jhpark16/Li-ion-Battery-Charger-Discharger/Simulation/Li-ion_Charger_Circuit_Simulation.asc

Li-ion_Battery: voltage; 8.4; Rser=0.1
M1: nmos; IRFZ44N
Q1: npn; 2N3904
R1: res; 10k
R2: res; 330k
R3: res; 150k
R4: res; 0.1
R5: res; 0.5
R6: res; 470k
R7: res; 150k
R8: res; 470k
R9: res; 556.42
R10: res; 100k
U1: opamp2; LM358
U2: opamp2; LM358
U3: opamp2; LM358
V1: voltage; 9; Rser=0.01
V2: voltage; PULSE(0 2 30 1ms 1ms 30 60 1)
Named nets: 0
.include LM358.sub
Vout1
Vout2
.tran 60
