jhpark16/Li-ion-Battery-Charger-Discharger/Src/main.c

/**
  ******************************************************************************
  * @file           : main.c
  * @brief          : Main program body
  ******************************************************************************
  * This notice applies to any and all portions of this file
  * that are not between comment pairs USER CODE BEGIN and
  * USER CODE END. Other portions of this file, whether 
  * inserted by the user or by software development tools
  * are owned by their respective copyright owners.
  *
  * Copyright (c) 2018 STMicroelectronics International N.V. 
  * All rights reserved.
  *
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
  ******************************************************************************
  */
/* Includes ------------------------------------------------------------------*/
#include "main.h"
#include "stm32f1xx_hal.h"
#include "cmsis_os.h"
#include "usb_device.h"

/* USER CODE BEGIN Includes */
#include "usbd_cdc_if.h"
#include "pcf8574.h"
#include "hd44780.h"

/* USER CODE END Includes */

ADC_HandleTypeDef hadc1;
ADC_HandleTypeDef hadc2;

I2C_HandleTypeDef hi2c1;

RTC_HandleTypeDef hrtc;

TIM_HandleTypeDef htim1;

osThreadId defaultTaskHandle;
osThreadId Task2Handle;
osThreadId Task3Handle;

/* USER CODE BEGIN PV */
#define USB_TX_BUFFER_SIZE 64
#define USB_RX_BUFFER_SIZE 64
 
uint8_t usbCdcTxBuffer[USB_TX_BUFFER_SIZE];
uint8_t usbCdcTxBuffer2[USB_TX_BUFFER_SIZE];
uint8_t usbCdcRxBuffer[USB_RX_BUFFER_SIZE];
int received_data_size = 0;
int receive_total =0; 		

uint8_t toggle=0;
//PCF8574_HandleTypeDef	pcf;
LCD_PCF8574_HandleTypeDef	lcd;

/* Buffers used for displaying Time and Date */
uint32_t startCounter;
uint8_t aShowTime[50] = {0};
uint8_t aShowDate[50] = {0};
int ema_N=60;
double ema_k, ema_Vvalue=0.0, ema_Avalue=0.0;

/* USER CODE END PV */

void SystemClock_Config(void);
static void MX_GPIO_Init(void);
static void MX_TIM1_Init(void);
static void MX_I2C1_Init(void);
static void MX_RTC_Init(void);
static void MX_ADC1_Init(void);
static void MX_ADC2_Init(void);
void StartDefaultTask(void const * argument);
void vTask2(void const * argument);
void vTask3(void const * argument);

/* USER CODE BEGIN PFP */
static void RTC_CalendarConfig(void);
static void RTC_CalendarShow(uint8_t *showtime, uint8_t *showdate);
static uint32_t RTC_ReadTimeCounter(RTC_HandleTypeDef* hrtc);

#define ITM_Port8(n)    (*((volatile unsigned char *)(0xE0000000+4*n)))
#define ITM_Port16(n)   (*((volatile unsigned short*)(0xE0000000+4*n)))
#define ITM_Port32(n)   (*((volatile unsigned long *)(0xE0000000+4*n)))

#define DEMCR           (*((volatile unsigned long *)(0xE000EDFC)))
#define TRCENA          0x01000000

struct __FILE { int handle; /* Add whatever you need here */ };
FILE __stdout;
FILE __stdin;

int fputc(int ch, FILE *f) {
//  if (DEMCR & TRCENA) {
//    while (ITM_Port32(0) == 0);
//    ITM_Port8(0) = ch;
//  }
  ITM_SendChar(ch);
  return(ch);
}


/* USER CODE END PFP */

/**
  * @brief  The application entry point.
  *
  * @retval None
  */
int main(void)
{
  /* MCU Configuration----------------------------------------------------------*/

  /* Reset of all peripherals, Initializes the Flash interface and the Systick. */
  HAL_Init();

  /* Configure the system clock */
  SystemClock_Config();

  /* Initialize all configured peripherals */
  MX_GPIO_Init();
  MX_TIM1_Init();
  MX_I2C1_Init();
  MX_RTC_Init();
  MX_ADC1_Init();
  MX_ADC2_Init();
  /* USER CODE BEGIN 2 */

  // Start the timer 1
  HAL_TIM_Base_Start_IT(&htim1);

  // LCDI2C_init
  // The I2C address is 0x20 + A2,A1,A0
  // A2, A1, A0 of PCF8574 are high (open)
  lcd.pcf8574.PCF_I2C_ADDRESS = 0x27;
  lcd.pcf8574.PCF_I2C_TIMEOUT = 1000;
  lcd.pcf8574.i2c.Instance = I2C1;
  lcd.pcf8574.i2c.Init.ClockSpeed = 400000;
  lcd.NUMBER_OF_LINES = NUMBER_OF_LINES_2; // Just use 2 lines instead of 4
  lcd.type = TYPE0;

  if(LCD_Init(&lcd)!=LCD_OK){
	  // error occured
    Error_Handler();
  }
  // Setup the initial value of real time calendar
  RTC_CalendarConfig();
  // update the startCounter value
  startCounter = RTC_ReadTimeCounter(&hrtc);

	// Calibrate ADC1
  if (HAL_ADCEx_Calibration_Start(&hadc1) != HAL_OK)
  {
    // Calibration Error 
    Error_Handler();
  }
  // Calibrate ADC2
  if (HAL_ADCEx_Calibration_Start(&hadc2) != HAL_OK)
  {
    // Calibration Error
    Error_Handler();
  }
	
  /* USER CODE END 2 */

  /* USER CODE BEGIN RTOS_MUTEX */
  /* add mutexes, ... */
  /* USER CODE END RTOS_MUTEX */

  /* USER CODE BEGIN RTOS_SEMAPHORES */
  /* add semaphores, ... */
  /* USER CODE END RTOS_SEMAPHORES */

  /* USER CODE BEGIN RTOS_TIMERS */
  /* start timers, add new ones, ... */
  /* USER CODE END RTOS_TIMERS */

  /* Create the thread(s) */
  /* definition and creation of defaultTask */
  osThreadDef(defaultTask, StartDefaultTask, osPriorityNormal, 0, 192);
  defaultTaskHandle = osThreadCreate(osThread(defaultTask), NULL);

  /* definition and creation of Task2 */
  osThreadDef(Task2, vTask2, osPriorityLow, 0, 192);
  Task2Handle = osThreadCreate(osThread(Task2), NULL);

  /* definition and creation of Task3 */
  osThreadDef(Task3, vTask3, osPriorityIdle, 0, 128);
  Task3Handle = osThreadCreate(osThread(Task3), NULL);

  /* USER CODE BEGIN RTOS_THREADS */
  /* add threads, ... */
  /* USER CODE END RTOS_THREADS */

  /* USER CODE BEGIN RTOS_QUEUES */
  /* add queues, ... */
  /* USER CODE END RTOS_QUEUES */
 

  /* Start scheduler */
  osKernelStart();
  
  /* We should never get here as control is now taken by the scheduler */

  /* Infinite loop */
  /* USER CODE BEGIN WHILE */
  while (1)
  {
  /* USER CODE END WHILE */

  /* USER CODE BEGIN 3 */

  }
  /* USER CODE END 3 */

}

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
/* USER CODE BEGIN 4 */
/**
  * @brief  Configure the current time and date.
  * @param  None
  * @retval None
  */
static void RTC_CalendarConfig(void)
{
  RTC_DateTypeDef sdatestructure;
  RTC_TimeTypeDef stimestructure;

  /*##-1- Configure the Date #################################################*/
  /* Set Date: Friday June 1st 2018 */
  sdatestructure.Year = 0x18;
  sdatestructure.Month = RTC_MONTH_JUNE;
  sdatestructure.Date = 0x1;
  sdatestructure.WeekDay = RTC_WEEKDAY_FRIDAY;
  
  if(HAL_RTC_SetDate(&hrtc,&sdatestructure,RTC_FORMAT_BCD) != HAL_OK)
  {
    /* Initialization Error */
    Error_Handler();
  }

  /*##-2- Configure the Time #################################################*/
  /* Set Time: 02:00:00 */
	if (HAL_RTCEx_BKUPRead(&hrtc, RTC_BKP_DR1) != 0x32F2)
	{
		stimestructure.Hours = 0x02;
		stimestructure.Minutes = 0x00;
		stimestructure.Seconds = 0x00;
		
		if (HAL_RTC_SetTime(&hrtc, &stimestructure, RTC_FORMAT_BCD) != HAL_OK)
		{
			/* Initialization Error */
			Error_Handler();
		}
		HAL_RTCEx_BKUPWrite(&hrtc, RTC_BKP_DR1, 0x32F2);
	}
			/*##-3- Writes a data in a RTC Backup data Register1 #######################*/
}

/**
  * @brief  Display the current time and date.
  * @param  showtime : pointer to buffer
  * @param  showdate : pointer to buffer
  * @retval None
  */
static void RTC_CalendarShow(uint8_t *showtime, uint8_t *showdate)
{
  RTC_DateTypeDef sdatestructureget;
  RTC_TimeTypeDef stimestructureget;

  /* Get the RTC current Time */
  HAL_RTC_GetTime(&hrtc, &stimestructureget, RTC_FORMAT_BIN);
  /* Get the RTC current Date */
  HAL_RTC_GetDate(&hrtc, &sdatestructureget, RTC_FORMAT_BIN);
  /* Display time Format : hh:mm:ss */
  sprintf((char *)showtime, "%2d:%2d:%2d", stimestructureget.Hours, stimestructureget.Minutes, stimestructureget.Seconds);
  /* Display date Format : mm-dd-yy */
  sprintf((char *)showdate, "%2d-%2d-%2d", sdatestructureget.Month, sdatestructureget.Date, 2000 + sdatestructureget.Year);
}

static uint32_t RTC_ReadTimeCounter(RTC_HandleTypeDef* hrtc)
{
  uint16_t high1 = 0U, high2 = 0U, low = 0U;
  uint32_t timecounter = 0U;

  high1 = READ_REG(hrtc->Instance->CNTH & RTC_CNTH_RTC_CNT);
  low   = READ_REG(hrtc->Instance->CNTL & RTC_CNTL_RTC_CNT);
  high2 = READ_REG(hrtc->Instance->CNTH & RTC_CNTH_RTC_CNT);

  if (high1 != high2)
  { /* In this case the counter roll over during reading of CNTL and CNTH registers, 
       read again CNTL register then return the counter value */
    timecounter = (((uint32_t) high2 << 16U) | READ_REG(hrtc->Instance->CNTL & RTC_CNTL_RTC_CNT));
  }
  else
  { /* No counter roll over during reading of CNTL and CNTH registers, counter 
       value is equal to first value of CNTL and CNTH */
    timecounter = (((uint32_t) high1 << 16U) | low);
  }

  return timecounter;
}

/* USER CODE END 4 */

/* StartDefaultTask function */
void StartDefaultTask(void const * argument)
{
  /* init code for USB_DEVICE */
  MX_USB_DEVICE_Init();

  /* USER CODE BEGIN 5 */
	int maxSize = 0;
  /* Infinite loop */
  for(int i=0;;i++)
  {
		printf("Task Default:%d\n",i);
		if(hUsbDeviceFS.dev_state == USBD_STATE_CONFIGURED)
		{
      USBD_CDC_SetRxBuffer(&hUsbDeviceFS, usbCdcRxBuffer);
		  USBD_CDC_ReceivePacket(&hUsbDeviceFS);
			int size = USBD_LL_GetRxDataSize(&hUsbDeviceFS, CDC_OUT_EP);
			if(size>maxSize) maxSize = size;
  		LCD_SetLocation(&lcd,14,3);
	  	LCD_WriteNumber(&lcd,maxSize,10);
			sprintf((char*)usbCdcTxBuffer,"Test%d\n",i);
			int n = strlen((char*)usbCdcTxBuffer);
			LCD_SetLocation(&lcd, 0, 3);
			if (hUsbDeviceFS.dev_state == USBD_STATE_CONFIGURED)
			{
				USBD_CDC_SetTxBuffer(&hUsbDeviceFS, usbCdcTxBuffer, n);
				USBD_CDC_TransmitPacket(&hUsbDeviceFS);
				CDC_Transmit_FS(usbCdcTxBuffer, n);
				LCD_WriteString(&lcd,"USB connected=      ");
			}
			else
			{
				LCD_WriteString(&lcd,"USB disconnected    ");
			}
		}
    osDelay(1000);
  }
  /* USER CODE END 5 */ 
}

/* vTask2 function */
void vTask2(void const * argument)
{
  /* USER CODE BEGIN vTask2 */
	char iMode = 1; // discharge = 1, charging = 2
  double voltage;
  double current;
	// Conversion factor for voltage measurement
	double cnvVFactor = 1.0/4091.0*(3.3*0.989965903)/0.327317676;
	// Conversion factor for current measurement
	double cnvAFactor = 1.0/4091.0*(3.3*0.989965903)*0.28714866;
	// Calculate k parameter for exponential moving average
	ema_k = 2.0/(ema_N+1.0);
	// Clear LCD
	LCD_ClearDisplay(&lcd);
  // Set the location to (0,0) the first column and the first line
  LCD_SetLocation(&lcd, 0, 0);
  // Write voltage and current labels
  if (iMode==1)
    LCD_WriteString(&lcd, "Discharging!");
  else
    LCD_WriteString(&lcd, "Charging!");
	// Set the location to (0,1) the first column and the second line
	LCD_SetLocation(&lcd, 0, 1);
	// Write voltage and current labels
	LCD_WriteString(&lcd, "V=      V I=     A");
  // Start the charging or discharging
	HAL_GPIO_WritePin(CurrentSourceCtrl_GPIO_Port, CurrentSourceCtrl_Pin, GPIO_PIN_RESET);
  // Wait until the voltage and current become stable.
  osDelay(50);
  // Start the conversion of ADC1
	if (HAL_ADC_Start(&hadc1) != HAL_OK) {
		/* ADC conversion start error */
		Error_Handler();
	}
  // Start the conversion of ADC2
	if (HAL_ADC_Start(&hadc2) != HAL_OK) {
		/* ADC conversion start error */
		Error_Handler();
	}
  // Check the end of conversion for ADC1
	if (HAL_ADC_PollForConversion(&hadc1, 50) != HAL_OK) {
		/* ADC polling error */
		Error_Handler();
	}
  // Check the end of conversion for ADC2
	if (HAL_ADC_PollForConversion(&hadc2, 50) != HAL_OK)	{
		/* ADC polling error */
		Error_Handler();
	}
	// Get the values from ADC1 and ADC2 and update moving average values
	uint32_t iVValue = HAL_ADC_GetValue(&hadc1);
	ema_Vvalue =  iVValue;
	uint32_t iAValue = HAL_ADC_GetValue(&hadc2);
	ema_Avalue =  iAValue;
  // Infinite loop 
  for(int i=0;;i++)
  {
		printf("Task2:%d\n",i); // Debug message
		if (HAL_ADC_Start(&hadc1) != HAL_OK) {
			/* ADC conversion start error */
			Error_Handler();
		}
		if (HAL_ADC_Start(&hadc2) != HAL_OK) {
			/* ADC conversion start error */
			Error_Handler();
		}
		if (HAL_ADC_PollForConversion(&hadc1, 50) != HAL_OK) {
			/* ADC polling error */
			Error_Handler();
		}
		if (HAL_ADC_PollForConversion(&hadc2, 50) != HAL_OK) {
			/* ADC polling error */
			Error_Handler();
		}
		iVValue = HAL_ADC_GetValue(&hadc1);
		// Update the moving average for voltage
		ema_Vvalue = iVValue*ema_k+ema_Vvalue*(1.0-ema_k);
		iAValue = HAL_ADC_GetValue(&hadc2);
    // Update the moving average for current
		ema_Avalue = iAValue*ema_k+ema_Avalue*(1.0-ema_k);
		voltage = ema_Vvalue*cnvVFactor;
		current = ema_Avalue*cnvAFactor;
		// STM32 cannot reliably measure voltage less than 0.1V
		if (current <0.1) current = 0.0;
		// Display the voltage and current estimated using exponential moving average
		LCD_SetLocation(&lcd, 0, 1);
		sprintf((char*)usbCdcTxBuffer,"V=%6.4fV I=%5.3fA",voltage,current);
		LCD_WriteString(&lcd,(char*) usbCdcTxBuffer);
    // Show the time at the third line
		//RTC_CalendarShow(aShowTime, aShowDate);
		//LCD_SetLocation(&lcd, 0, 2);
		//LCD_WriteString(&lcd,(char*) aShowTime);
		uint32_t currentCounter = RTC_ReadTimeCounter(&hrtc);
		currentCounter -= startCounter;
		if(iMode){
		  // Display the current time and calculated capacity (mAh) at the third line
			LCD_SetLocation(&lcd,0,2);
			sprintf((char*)usbCdcTxBuffer,"%5u sec %6.1f mAh",(unsigned int)currentCounter,currentCounter/3.6*0.5);
			LCD_WriteString(&lcd,(char*) usbCdcTxBuffer);
			// If the voltage reached the threshold value, turn the dis/charging off
			if(currentCounter >= 30 && iMode == 1 && voltage <6.00) {
				HAL_GPIO_WritePin(CurrentSourceCtrl_GPIO_Port, CurrentSourceCtrl_Pin, GPIO_PIN_SET);
				iMode = 0;
			}
			else if(currentCounter >= 30 && iMode == 2 && voltage >8.46) { // with 8.7V supply voltage
				HAL_GPIO_WritePin(CurrentSourceCtrl_GPIO_Port, CurrentSourceCtrl_Pin, GPIO_PIN_SET);
				iMode = 0;
			}
		}
		voltage = iVValue*cnvVFactor;
		current = iAValue*cnvAFactor;
		// Show the raw voltage and current values
		LCD_SetLocation(&lcd, 0, 3);
		sprintf((char*)usbCdcTxBuffer,"%6.4fV, %5.3fA",voltage,current);
		LCD_WriteString(&lcd,(char*) usbCdcTxBuffer);
    osDelay(490);
  }
  /* USER CODE END vTask2 */
}

/* vTask3 function */
void vTask3(void const * argument)
{
  /* USER CODE BEGIN vTask3 */
  // Infinite loop 
  for(int i=0;;i++)
  {
		printf("Task3 LED blinking:%d\n",i);
		HAL_GPIO_WritePin(LED_GPIO_Port, LED_Pin, GPIO_PIN_RESET);
    osDelay(500);
		HAL_GPIO_WritePin(LED_GPIO_Port, LED_Pin, GPIO_PIN_SET);
    osDelay(500);
  }
  /* USER CODE END vTask3 */
}

/**
  * @brief  Period elapsed callback in non blocking mode
  * @note   This function is called  when TIM4 interrupt took place, inside
  * HAL_TIM_IRQHandler(). It makes a direct call to HAL_IncTick() to increment
  * a global variable "uwTick" used as application time base.
  * @param  htim : TIM handle
  * @retval None
  */
void HAL_TIM_PeriodElapsedCallback(TIM_HandleTypeDef *htim)
{
  if (htim->Instance == TIM4) {
    HAL_IncTick();
  }
}

/**
  * @brief  This function is executed in case of error occurrence.
  * @param  file: The file name as string.
  * @param  line: The line in file as a number.
  * @retval None
  */
void _Error_Handler(char *file, int line)
{
  /* USER CODE BEGIN Error_Handler_Debug */
  /* User can add his own implementation to report the HAL error return state */
  while(1)
  {
  }
  /* USER CODE END Error_Handler_Debug */
}

#ifdef  USE_FULL_ASSERT
/**
  * @brief  Reports the name of the source file and the source line number
  *         where the assert_param error has occurred.
  * @param  file: pointer to the source file name
  * @param  line: assert_param error line source number
  * @retval None
  */
void assert_failed(uint8_t* file, uint32_t line)
{ 
  /* USER CODE BEGIN 6 */
  /* User can add his own implementation to report the file name and line number,
     tex: printf("Wrong parameters value: file %s on line %d\r\n", file, line) */
  /* USER CODE END 6 */
}
#endif /* USE_FULL_ASSERT */

/**
  * @}
  */

/**
  * @}
  */

/************************ (C) COPYRIGHT STMicroelectronics *****END OF FILE****/
