jhpark16/Li-ion-Battery-Charger-Discharger/Li-ion Battery Charger-Discharger.ioc

Mcu.UserName=STM32F103CBTx
PA0-WKUP.Signal=ADCx_IN0
PA1.Signal=ADCx_IN1
PA11.Signal=USB_DM
PA12.Signal=USB_DP
PA13.GPIO_Label=SWDIO
PA13.Signal=SYS_JTMS-SWDIO
PA14.GPIO_Label=SWCLK
PA14.Signal=SYS_JTCK-SWCLK
PA8.Signal=RCC_MCO
PB12.GPIO_Label=SquareOut
PB12.Signal=GPIO_Output
PB3.GPIO_Label=TRACESWO
PB3.Signal=SYS_JTDO-TRACESWO
PB5.GPIO_Label=CurrentSourceCtrl
PB5.Signal=GPIO_Output
PB6.Signal=I2C1_SCL
PB7.Signal=I2C1_SDA
PC13-TAMPER-RTC.GPIO_Label=LED
PC13-TAMPER-RTC.Signal=GPIO_Output
PD0-OSC_IN.Signal=RCC_OSC_IN
PD1-OSC_OUT.Signal=RCC_OSC_OUT
