jhpark16/Li-ion-Battery-Charger-Discharger/(commit log)

2018-06-15 Update for stability
    [Li-ion Battery Charger-Discharger Debug.cfg, Li-ion Battery Charger-Discharger Release.cfg]
2018-06-16 Updated the picture of the charger setup and code
